mattyams/kudox-keyboard/kudox-game/rev2/kudox_game.kicad_pcb

## KiCad design kudox-game/rev2/kudox_game.kicad_pcb (2021-12-20)

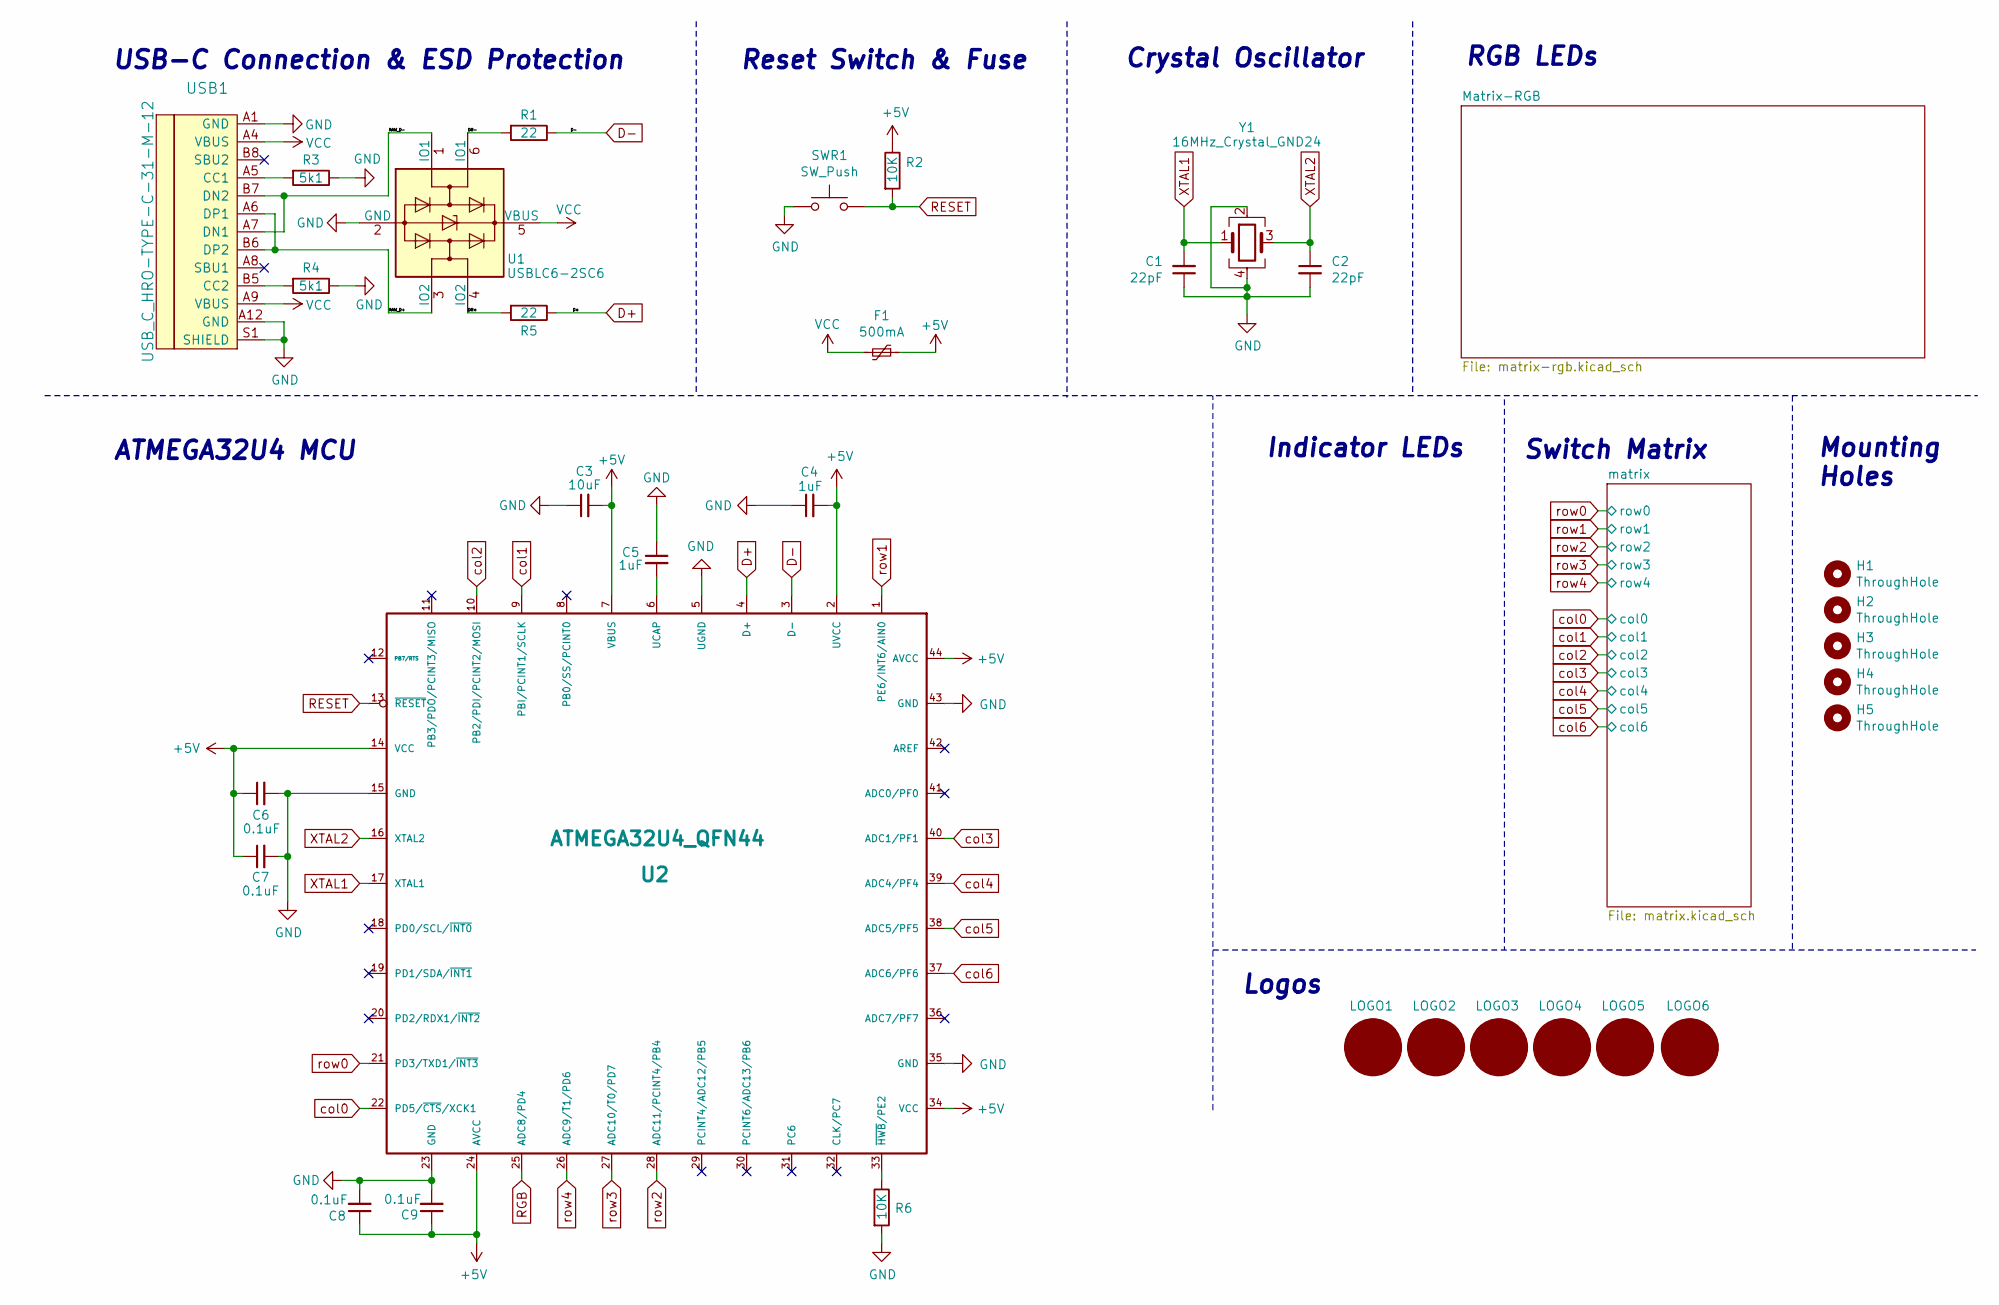
[picture p1: schematic kudox_game.kicad_sch, Kudox Game keyboard]

Parts:
C1, C2: 22pF; C_0805_2012Metric_Pad1.18x1.45mm_HandSolder; LCSC C1804
C3: 10uF; C_0805_2012Metric_Pad1.18x1.45mm_HandSolder; LCSC C15850
C4, C5: 1uF; C_0805_2012Metric_Pad1.18x1.45mm_HandSolder; LCSC C28323
C6, C7, C8, C9: 0.1uF; C_0805_2012Metric_Pad1.18x1.45mm_HandSolder; LCSC C28233
F1: 500mA; Fuse_1206_3216Metric_Pad1.42x1.75mm_HandSolder; LCSC C70068
H1, H2, H3, H4, H5: ThroughHole; HOLE_M3
LOGO1, LOGO2: arisutea_logo; warning_sign_3.6x3.2mm
LOGO3, LOGO4: OSHW Logo; osh-logo
LOGO5, LOGO6: QMK_Logo_Light
R1, R5: 22; R_0805_2012Metric_Pad1.20x1.40mm_HandSolder; LCSC C17561
R2, R6: 10K; R_0805_2012Metric_Pad1.20x1.40mm_HandSolder; LCSC C17414
R3, R4: 5k1; R_0805_2012Metric_Pad1.20x1.40mm_HandSolder; LCSC C27834
SWR1: SW_Push; SW_SPST_TL3342; LCSC C318884
U1: USBLC6-2SC6; SOT-23-6_Handsoldering; LCSC C7519
U2: ATMEGA32U4_QFN44; TQFP-44_10x10mm_P0.8mm; LCSC C44854
USB1: USB_C_HRO-TYPE-C-31-M-12; USB_C-31-M-12; LCSC C319148
Y1: 16MHz_Crystal_GND24; Crystal_SMD_TXC_7M-4Pin_3.2x2.5mm_HandSoldering; LCSC C89371

Connections:
+5V: C3.2, C4.2, C6.1, C7.1, C8.1, C9.1, F1.1, R2.1, U2.2 (UVCC), U2.7 (VBUS), U2.14 (VCC), U2.24 (AVCC), U2.34 (VCC), U2.44 (AVCC); also elsewhere on the board
/DR+: R5.2, U1.4 (IO2)
/DR-: R1.2, U1.6 (IO1)
/RAW_D+: U1.3 (IO2), USB1.A6 (DP1), USB1.B6 (DP2)
/RAW_D-: U1.1 (IO1), USB1.A7 (DN1), USB1.B7 (DN2)
D+: R5.1, U2.4 (D+)
D-: R1.1, U2.3 (D-)
GND: C1.1, C2.2, C3.1, C4.1, C5.1, C6.2, C7.2, C8.2, C9.2, R3.1, R4.1, R6.2, SWR1.1, U1.2 (GND), U2.5 (UGND), U2.15 (GND), U2.23 (GND), U2.35 (GND), U2.43 (GND), USB1.A1 (GND), USB1.A12 (GND), USB1.S1 (SHIELD), Y1.2, Y1.4; also elsewhere on the board
unnamed: C5.2, U2.6 (UCAP)
unnamed: R3.2, USB1.A5 (CC1)
unnamed: R4.2, USB1.B5 (CC2)
unnamed: R6.1, U2.33 (~HWB/PE2)
RESET: R2.2, SWR1.2, U2.13 (~RESET)
RGB: U2.25 (ADC8/PD4); also elsewhere on the board
VCC: F1.2, U1.5 (VBUS), USB1.A4 (VBUS), USB1.A9 (VBUS)
XTAL1: C1.2, U2.17 (XTAL1), Y1.1
XTAL2: C2.1, U2.16 (XTAL2), Y1.3
col0: U2.22 (PD5/~CTS/XCK1); also elsewhere on the board
col1: U2.9 (PBI/PCINT1/SCLK); also elsewhere on the board
col2: U2.10 (PB2/PDI/PCINT2/MOSI); also elsewhere on the board
col3: U2.40 (ADC1/PF1); also elsewhere on the board
col4: U2.39 (ADC4/PF4); also elsewhere on the board
col5: U2.38 (ADC5/PF5); also elsewhere on the board
col6: U2.37 (ADC6/PF6); also elsewhere on the board
row0: U2.21 (PD3/TXD1/~INT3); also elsewhere on the board
row1: U2.1 (PE6/INT6/AIN0); also elsewhere on the board
row2: U2.28 (ADC11/PCINT4/PB4); also elsewhere on the board
row3: U2.27 (ADC10/T0/PD7); also elsewhere on the board
row4: U2.26 (ADC9/T1/PD6); also elsewhere on the board

Notes on the sheet:
Indicator LEDs
ATMEGA32U4 MCU
USB-C Connection & ESD Protection
Logos
Mounting Holes
Reset Switch & Fuse
Switch Matrix
RGB LEDs
Crystal Oscillator

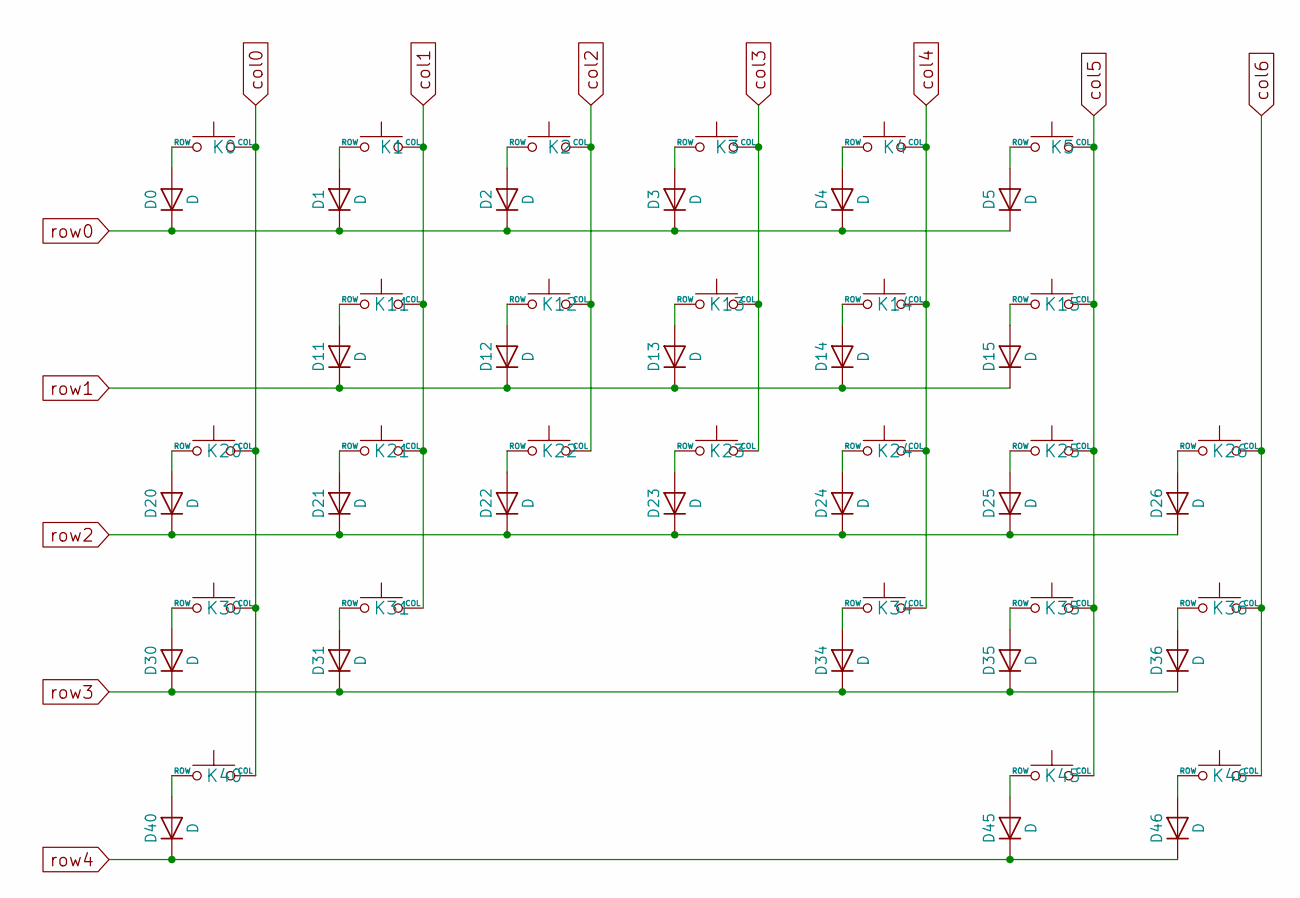
[picture p2: schematic matrix.kicad_sch]

Parts:
D0, D1, D2, D3, D4, D5, D11, D12, D13, D14, D15, D20, D21, D22, D23, D24, D25, D26, D30, D31, D34, D35, D36, D40, D45, D46: D; D_THT_7.62_SOD-123_Single_Side
K0, K1, K2, K3, K4, K5, K11, K12, K13, K14, K15, K20, K21, K22, K23, K24, K25, K26, K31, K34, K35, K36: KEYSW; SW_Hotswap_Kailh_1.00u
K30, K40, K45: KEYSW; SW_Hotswap_Kailh_1.50u
K46: KEYSW; SW_Hotswap_Kailh_2.00u

Connections:
unnamed: D0.2 (A), K0.2 (ROW)
unnamed: D1.2 (A), K1.2 (ROW)
unnamed: D2.2 (A), K2.2 (ROW)
unnamed: D3.2 (A), K3.2 (ROW)
unnamed: D4.2 (A), K4.2 (ROW)
unnamed: D5.2 (A), K5.2 (ROW)
unnamed: D11.2 (A), K11.2 (ROW)
unnamed: D12.2 (A), K12.2 (ROW)
unnamed: D13.2 (A), K13.2 (ROW)
unnamed: D14.2 (A), K14.2 (ROW)
unnamed: D15.2 (A), K15.2 (ROW)
unnamed: D20.2 (A), K20.2 (ROW)
unnamed: D21.2 (A), K21.2 (ROW)
unnamed: D22.2 (A), K22.2 (ROW)
unnamed: D23.2 (A), K23.2 (ROW)
unnamed: D24.2 (A), K24.2 (ROW)
unnamed: D25.2 (A), K25.2 (ROW)
unnamed: D26.2 (A), K26.2 (ROW)
unnamed: D30.2 (A), K30.2 (ROW)
unnamed: D31.2 (A), K31.2 (ROW)
unnamed: D34.2 (A), K34.2 (ROW)
unnamed: D35.2 (A), K35.2 (ROW)
unnamed: D36.2 (A), K36.2 (ROW)
unnamed: D40.2 (A), K40.2 (ROW)
unnamed: D45.2 (A), K45.2 (ROW)
unnamed: D46.2 (A), K46.2 (ROW)
col0: K0.1 (COL), K20.1 (COL), K30.1 (COL), K40.1 (COL); also elsewhere on the board
col1: K1.1 (COL), K11.1 (COL), K21.1 (COL), K31.1 (COL); also elsewhere on the board
col2: K2.1 (COL), K12.1 (COL), K22.1 (COL); also elsewhere on the board
col3: K3.1 (COL), K13.1 (COL), K23.1 (COL); also elsewhere on the board
col4: K4.1 (COL), K14.1 (COL), K24.1 (COL), K34.1 (COL); also elsewhere on the board
col5: K5.1 (COL), K15.1 (COL), K25.1 (COL), K35.1 (COL), K45.1 (COL); also elsewhere on the board
col6: K26.1 (COL), K36.1 (COL), K46.1 (COL); also elsewhere on the board
row0: D0.1 (K), D1.1 (K), D2.1 (K), D3.1 (K), D4.1 (K), D5.1 (K); also elsewhere on the board
row1: D11.1 (K), D12.1 (K), D13.1 (K), D14.1 (K), D15.1 (K); also elsewhere on the board
row2: D20.1 (K), D21.1 (K), D22.1 (K), D23.1 (K), D24.1 (K), D25.1 (K), D26.1 (K); also elsewhere on the board
row3: D30.1 (K), D31.1 (K), D34.1 (K), D35.1 (K), D36.1 (K); also elsewhere on the board
row4: D40.1 (K), D45.1 (K), D46.1 (K); also elsewhere on the board

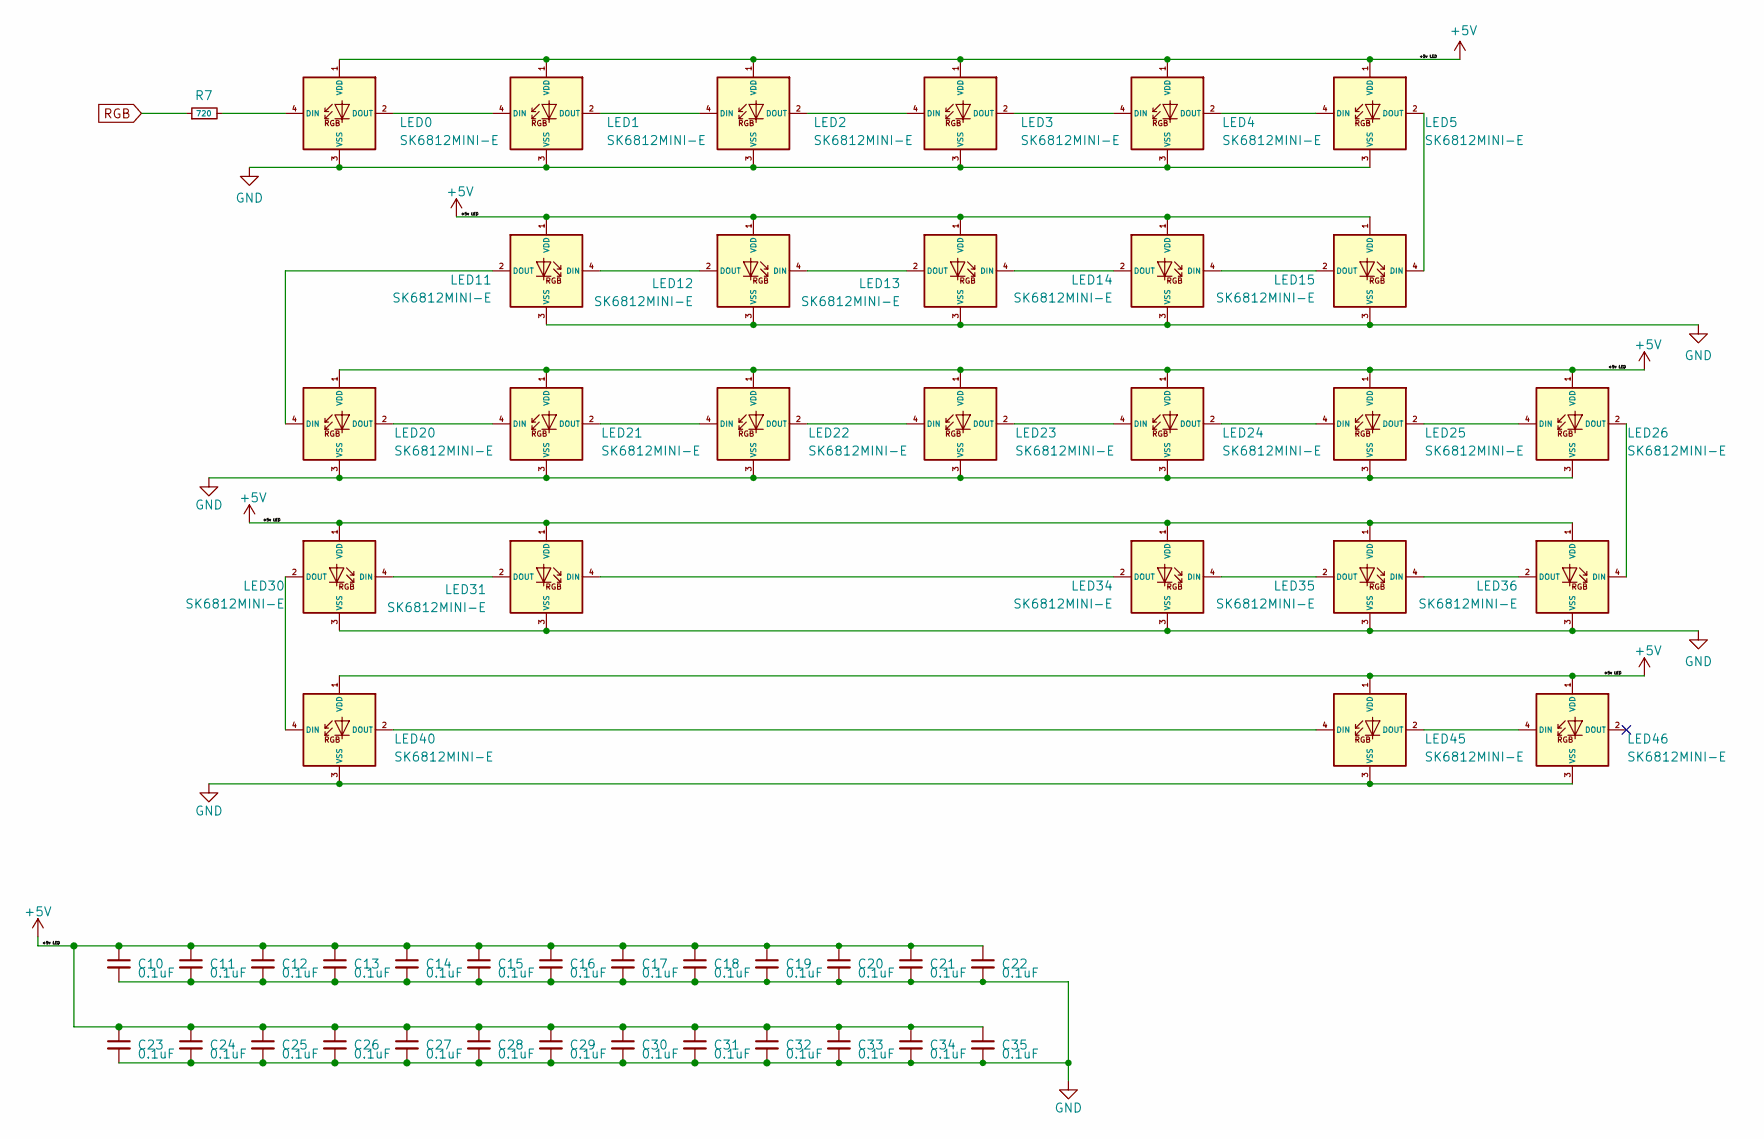
[picture p3: schematic matrix-rgb.kicad_sch]

Parts:
C10, C11, C12, C13, C14, C15, C16, C17, C18, C19, C20, C21, C22, C23, C24, C25, C26, C27, C28, C29, C30, C31, C32, C33, C34, C35: 0.1uF; C_0603_1608Metric_Pad1.08x0.95mm_HandSolder; LCSC C28233
LED0, LED1, LED2, LED3, LED4, LED5, LED20, LED21, LED22, LED23, LED24, LED25, LED26, LED40, LED45, LED46: SK6812MINI-E; LED_MX_SK6812MINI-E
LED11, LED12, LED13, LED14, LED15, LED30, LED31, LED34, LED35, LED36: SK6812MINI-E; LED_MX_SK6812MINI-E_REV
R7: 720; R_0805_2012Metric_Pad1.20x1.40mm_HandSolder; LCSC C17818

Connections:
+5V: C10.1, C11.1, C12.1, C13.1, C14.1, C15.1, C16.1, C17.1, C18.1, C19.1, C20.1, C21.1, C22.1, C23.1, C24.1, C25.1, C26.1, C27.1, C28.1, C29.1, C30.1, C31.1, C32.1, C33.1, C34.1, C35.1, LED0.1 (VDD), LED1.1 (VDD), LED2.1 (VDD), LED3.1 (VDD), LED4.1 (VDD), LED5.1 (VDD), LED11.1 (VDD), LED12.1 (VDD), LED13.1 (VDD), LED14.1 (VDD), LED15.1 (VDD), LED20.1 (VDD), LED21.1 (VDD), LED22.1 (VDD), LED23.1 (VDD), LED24.1 (VDD), LED25.1 (VDD), LED26.1 (VDD), LED30.1 (VDD), LED31.1 (VDD), LED34.1 (VDD), LED35.1 (VDD), LED36.1 (VDD), LED40.1 (VDD), LED45.1 (VDD), LED46.1 (VDD); also elsewhere on the board
GND: C10.2, C11.2, C12.2, C13.2, C14.2, C15.2, C16.2, C17.2, C18.2, C19.2, C20.2, C21.2, C22.2, C23.2, C24.2, C25.2, C26.2, C27.2, C28.2, C29.2, C30.2, C31.2, C32.2, C33.2, C34.2, C35.2, LED0.3 (VSS), LED1.3 (VSS), LED2.3 (VSS), LED3.3 (VSS), LED4.3 (VSS), LED5.3 (VSS), LED11.3 (VSS), LED12.3 (VSS), LED13.3 (VSS), LED14.3 (VSS), LED15.3 (VSS), LED20.3 (VSS), LED21.3 (VSS), LED22.3 (VSS), LED23.3 (VSS), LED24.3 (VSS), LED25.3 (VSS), LED26.3 (VSS), LED30.3 (VSS), LED31.3 (VSS), LED34.3 (VSS), LED35.3 (VSS), LED36.3 (VSS), LED40.3 (VSS), LED45.3 (VSS), LED46.3 (VSS); also elsewhere on the board
unnamed: LED1.2 (DOUT), LED2.4 (DIN)
unnamed: LED0.2 (DOUT), LED1.4 (DIN)
unnamed: LED2.2 (DOUT), LED3.4 (DIN)
unnamed: LED3.2 (DOUT), LED4.4 (DIN)
unnamed: LED4.2 (DOUT), LED5.4 (DIN)
unnamed: LED5.2 (DOUT), LED15.4 (DIN)
unnamed: LED11.2 (DOUT), LED20.4 (DIN)
unnamed: LED11.4 (DIN), LED12.2 (DOUT)
unnamed: LED12.4 (DIN), LED13.2 (DOUT)
unnamed: LED13.4 (DIN), LED14.2 (DOUT)
unnamed: LED14.4 (DIN), LED15.2 (DOUT)
unnamed: LED20.2 (DOUT), LED21.4 (DIN)
unnamed: LED21.2 (DOUT), LED22.4 (DIN)
unnamed: LED22.2 (DOUT), LED23.4 (DIN)
unnamed: LED23.2 (DOUT), LED24.4 (DIN)
unnamed: LED24.2 (DOUT), LED25.4 (DIN)
unnamed: LED25.2 (DOUT), LED26.4 (DIN)
unnamed: LED26.2 (DOUT), LED36.4 (DIN)
unnamed: LED30.2 (DOUT), LED40.4 (DIN)
unnamed: LED30.4 (DIN), LED31.2 (DOUT)
unnamed: LED31.4 (DIN), LED34.2 (DOUT)
unnamed: LED34.4 (DIN), LED35.2 (DOUT)
unnamed: LED35.4 (DIN), LED36.2 (DOUT)
unnamed: LED40.2 (DOUT), LED45.4 (DIN)
unnamed: LED45.2 (DOUT), LED46.4 (DIN)
unnamed: LED0.4 (DIN), R7.2
RGB: R7.1; also elsewhere on the board

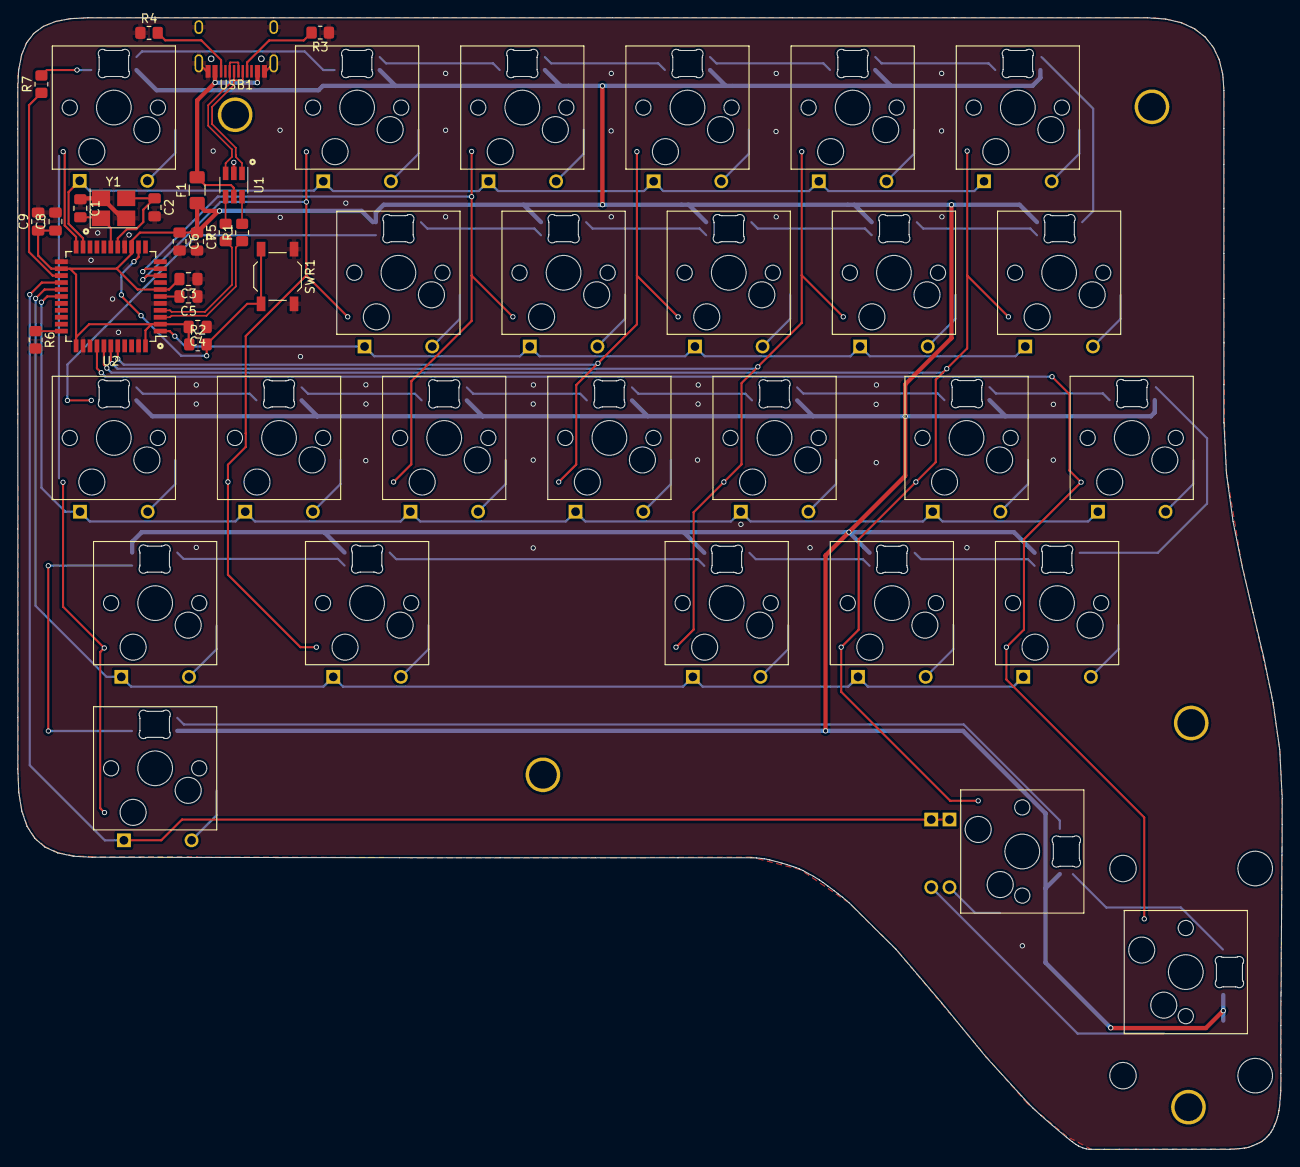
[picture p4: board kudox_game.kicad_pcb from above]

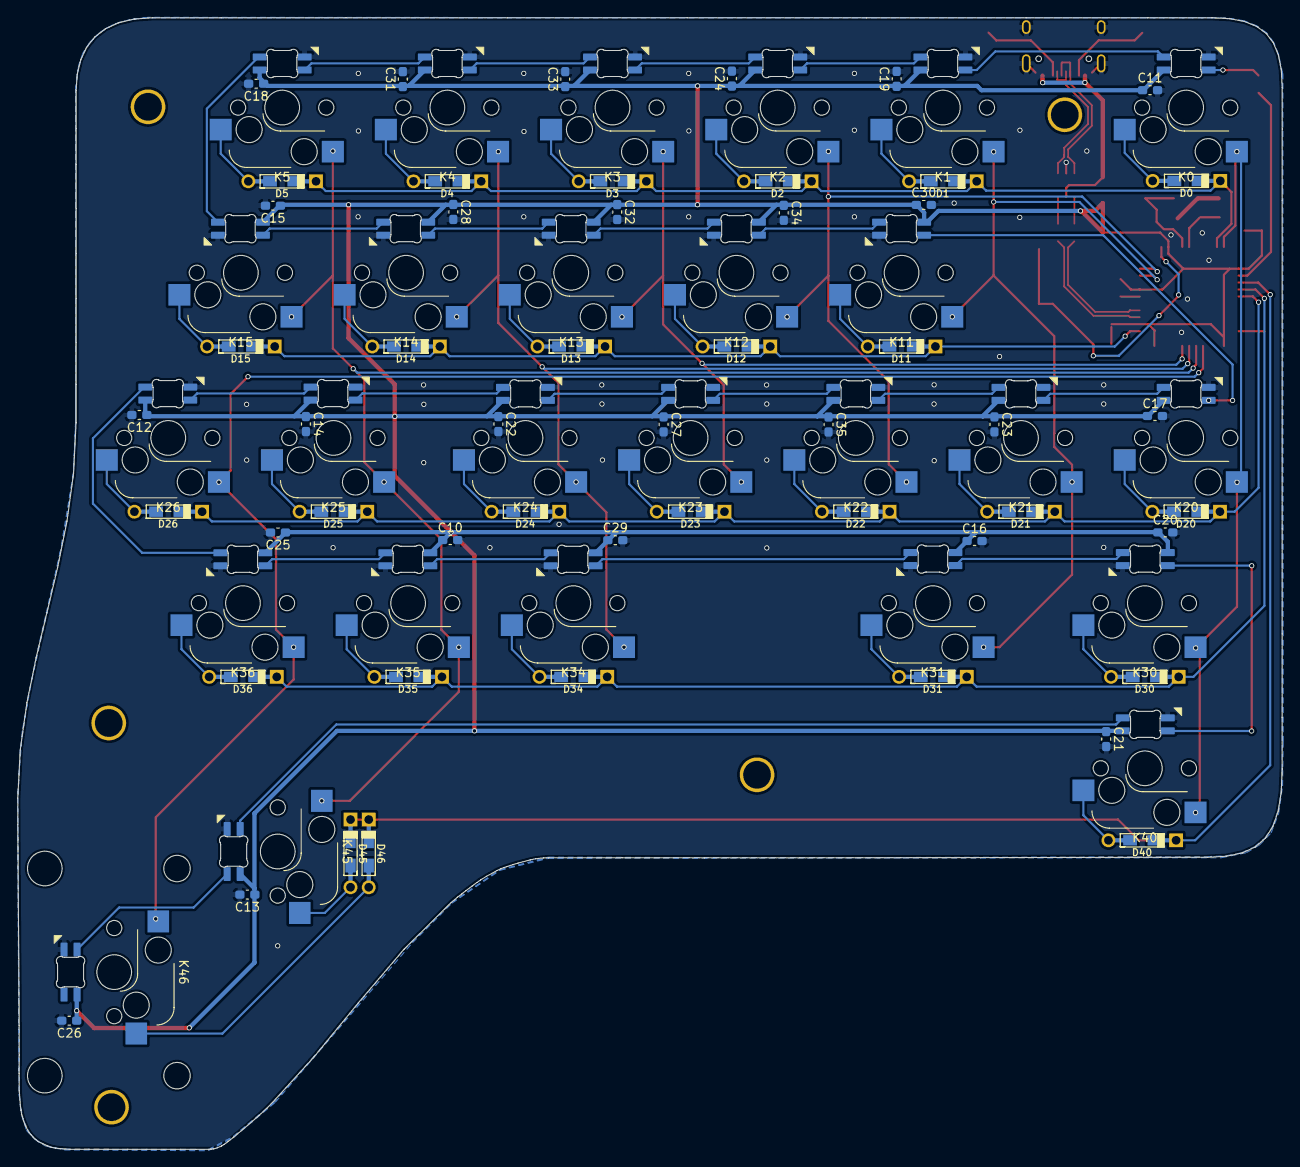
[picture p5: board kudox_game.kicad_pcb from below]

Board: 2 copper layers, 145.7 x 130.4 mm, 137 parts (52 on the bottom side), 81 nets.
